tnzhy06/fallguard/docs/C09验收.md

# C09：MQTT、JSON 与远程命令

日期：2026-10-26。当前 C09 已实现并通过 Debug 编译和软件回放；电脑端已使用新部署账户验证云 Broker 的认证及临时主题 QoS 0 收发。**用户于 2026-10-26 确认 C09 验收通过。** 下文保留开发过程记录；除已记录日志外，不补写用户未提供的独立测量结果。 本轮不进入 C10，也不开发网站。

## 1. 本轮接入

- USART3 保持 115200、单字节中断接收和固定环形缓冲；发送使用中断，主循环推进 AT 状态机。
- Wi-Fi/SNTP 之后接 MQTT；SNTP 没有有效时间也可继续联网，未校时 ts=0。
- 使用 LinkID=0、TCP、QoS 0、Retain=false、Clean Session、Keep Alive=120。
- 连接且命令主题订阅成功后立即上报快照，之后默认 5 秒；周期可设 1～3600 秒。
- 在线报警、消警发送事件并尽快更新状态快照；离线不积存历史事件，恢复后只发当前状态。
- 保留取消自动 GMR、关闭 RTC 周期时间行的设置；GPS/OLED 本地卫星数显示不改，MQTT 不含 sat。

## 2. 配置与烧录

Wi-Fi 使用本机 `BSP/esp_config_local.h`。MQTT 使用本机 `BSP/mqtt_config_local.h`，已按用户提供的桌面资料填写当前 `114.55.210.224:1883` 与 `mqtt_device` 账户；密码不写入本文。两份本地配置均被 Git 忽略，CMake 只在文件缺失时从公开空模板创建，不覆盖现有配置。

仅提取了 MQTT 连接凭据，没有复制桌面目录中的管理员、网站账户或 SSH 私钥。更新部署密码后修改本地配置并重新编译。

编译 Debug 后烧录 [fallguard.elf](../build/Debug/fallguard.elf)。首次验收建议保持现有 RTC、GPS、MPU6050 和 JQ8900 接线不变；室内没有有效 GPS 也能测试 MQTT。

## 3. 启动指令

```text
AT
ATE0
AT+CWMODE=1
AT+CWJAP="本地配置的SSID","本地配置的密码"
AT+CIPSNTPCFG=1,8,"ntp.aliyun.com","ntp.sjtu.edu.cn","cn.ntp.org.cn"
AT+CIPSNTPTIME?
AT+MQTTCLEAN=0
AT+MQTTUSERCFG=0,1,"belt01","本地配置的MQTT用户名","本地配置的MQTT密码",0,0,""
AT+MQTTCONNCFG=0,120,0,"","",0,0
AT+MQTTCONN=0,"114.55.210.224",1883,0
AT+MQTTSUB=0,"fallguard/belt01/cmd",0
```

每条实际指令以 CR-LF 结束，上一事务完成后才能发送下一条。Wi-Fi 和 MQTT 账户配置的 TX/回显隐藏凭据。CLEAN 在无旧会话时返回 ERROR 可继续；其他 MQTT 事务失败进入恢复。

连接同时等待匹配 Broker 的 `+MQTTCONNECTED` 和最终 OK，允许两者任意先后。订阅最终确认前不允许业务上报。发送用普通 AT+MQTTPUB，原始 JSON 经 AT 转义，包含 CR-LF 的实际文本不超过 255 字节，NUL 另占 1 字节。

## 4. MQTTX 配置

| 设置 | 值 |
| --- | --- |
| 主机 | mqtt://114.55.210.224 |
| 端口 | 1883，关闭 TLS |
| MQTT 版本 | 3.1.1 |
| Client ID | fallguard-mqttx-pc；不要使用 belt01 |
| 用户名/密码 | 当前 MQTT 账户，不是 Dashboard 管理员账户 |
| 订阅 | fallguard/#，QoS 0 |
| 发布控制 | fallguard/belt01/cmd，QoS 0，Retain=false |

订阅全部主题时会看到自己发送的 cmd，这不是设备 ACK。设备只有 loc/alarm 上报，没有专用命令执行确认字段。发送控制前检查命令主题无历史保留命令。

位置示例：

```json
{"id":"belt01","ts":0,"lat":0,"lon":0,"fix":0,"st":"ok"}
```

报警示例：

```json
{"id":"belt01","ts":0,"ev":"fall","lat":0,"lon":0,"fix":0}
```

消警示例：

```json
{"id":"belt01","ts":0,"ev":"cancel"}
```

实际 ts 来自有效 RTC，否则为 0；实际经纬度为整数微度。失锁保留历史坐标但 fix=0，从未定位为零坐标且 fix=0。

## 5. 下行验收

逐条向 cmd 主题发送：

```json
{"cmd":"loc"}
{"cmd":"clear"}
{"cmd":"intv","v":1}
{"cmd":"intv","v":5}
```

loc 尽快请求最新快照；clear 仅在报警中解除，不会在正常状态触发报警；intv 从处理时重新计周期，范围 1～3600，MCU 重启恢复 5 秒。正常网络重连保留已设置的周期。

错误 JSON、缺参数、未知字段/命令、重复键、带尾随垃圾、字符串/小数/指数周期，以及 0、3601 均拒绝。完整下行载荷最多 127 字节，另留 NUL；固定命令 FIFO 为 4 项。按 URC 声明长度取载荷，载荷内部换行或 OK 不作为普通 AT 应答处理。

## 6. OLED 与日志

默认显示第 8 页 MQTT 页面；K1 循环原有 GPS/MPU/RTC 等页面，K2 保留本地测试/消警。MQTT 页显示连接阶段、Wi-Fi、上报周期、AT 发布成功/失败计数、命令丢弃/无效计数与 RX 丢字节。

PUB 表示 ESP 对发布事务返回成功，不能据此保证订阅者收到。LED 在 MQTT 订阅就绪后切正常模式，未在线仍为离线模式；报警优先快闪。

`DEBUG_LOG_MQTT` 控制连接/发布日志，`DEBUG_LOG_REPORT` 控制命令与业务 JSON；ESP/ESP_RX 与 RTC 启动/校时日志继续保留。`DEBUG_LOG_TIME_PERIODIC=0`，不会每秒输出重复 RTC 时间或未校准状态。

## 7. 恢复与限制

- MQTT 连接事务超时 30 秒，其他 MQTT 事务 10 秒；失败或接收失步后等待 30 秒，EN 拉低 100 ms 再启动。没有阻塞式等待。
- SNTP 有响应但时间无效，30 秒窗口结束后继续 MQTT，后续有限频率重试；SNTP 明确拒绝则本次 MCU 运行禁用后续 SNTP 并继续 MQTT，已有 RTC 保留。
- SNTP 事务无最终响应时先恢复 ESP，避免迟到 OK 污染后续事务；本次运行跳过后续 SNTP，从而允许重新联网后进入 MQTT。
- 在线事件 FIFO 为 4 项，满时记录丢弃；断线清空，重连只发当前快照。没有持久事件存储或离线补报。
- 本地最新报警状态先记录，再执行远程 clear，避免同一轮发生/解除报警时丢失事件；重复 clear 幂等，扶正再触发语义不变。
- 上报与校时共用一个 AT 事务通道，“立即”指下一次通道可用时调度，不保证严格端到端时延。QoS 0 也不保证每条事件送达。

## 8. 验收清单

| 操作 | 预期 |
| --- | --- |
| 启动并等待订阅 | 输出 `[MQTT] connected and command topic subscribed`，MQTTX 收到首条 loc |
| 连续观察至少 3 条 | 默认约 5 秒间隔，JSON 无 sat、无浮点经纬度 |
| 室内无定位 | fix=0 仍可收发；时间未校准时 ts=0 仍可收发 |
| 发送 loc | 尽快收到一次快照，不改变周期 |
| K2 报警 | 收到 fall、st=fall 快照，语音和 LED 正常 |
| 发送 clear，再重复 clear | 收到一次 cancel、st=ok；不额外触发报警 |
| 保持倾斜消警后再扶正/放倒 | 未扶正不重触发；扶正后再达到 60°/1 秒可触发 |
| 周期改 1，再改 5 | 实测间隔变化；非法周期拒绝 |
| 周期改 3600 后报警/消警 | 事件及状态不等待周期到期；验收后恢复 5 秒 |
| 断网期间报警、消警再重连 | 本地功能继续，重连仅上报当前状态，无历史补发 |
| 检查并发 | 记录 IMU dt/max、GPS 错误/丢字节，确认 JQ 播放不破坏接收 |

已验证：Debug 编译，RAM 8536 B、FLASH 74856 B；修改模块严格警告检查；[MQTT/JSON/上报回放](../tests/mqtt/README.md)、C08 正常/空配置回归、实际调度器回放及 OLED 帧缓冲检查。

云端电脑测试首次出现超时，复测完成当前账户认证、独立临时主题订阅与 QoS 0 往返，Retain=false；没有发送设备控制命令、修改 Broker 或保留测试消息。这个结果不代替 ESP-01S 实物验收。

待验证：重新烧录后的 ESP-01S MQTT 应答、MQTTX 上行/下行、真实断网恢复及本地任务并发。后续请提供 `[ESP]`、`[MQTT]`、`[REPORT]` 日志，不提供密码。

## 9. 实物连接通知端口带引号（2026-10-26）

用户日志确认 Wi-Fi 已获得 IP、SNTP 返回有效日期并写入 RTC，MQTT 用户配置和连接参数均收到 OK。ESP 发出的连接通知为：

```text
+MQTTCONNECTED:0,1,"114.55.210.224","1883","",0
OK
```

原代码仅匹配不带引号的数字端口，导致通知被忽略，虽有 OK 仍等待匹配通知，30 秒后在 state=15 超时。已修正为接受实物的引号端口及手册示例的数字端口；仍严格核对 LinkID=0、TCP scheme=1、主机、端口、空 path 与 reconnect=0，不仅凭 OK 就进入订阅。

Debug、ESP 严格警告检查与 MQTT 回放通过；新增覆盖两种端口形式、URC/OK 两种先后，以及错误主机/端口/LinkID/尾部拒绝。修复后尚待重新烧录确认订阅、上报和下行；不能将此前连接通知当成完整 C09 验收通过。首次 CLEAN 返回 ERROR 已由既有代码允许继续，无需因此改服务器配置。

## 10. 云端直接订阅确认实物周期上报（2026-10-26）

用户提供周期发布 OK 日志后，电脑使用独立 Client ID 连接当前云 Broker，只读订阅 `fallguard/#` 15 秒，收到 3 条 `fallguard/belt01/loc`：时间戳依次为 1793026466、1793026471、1793026476，均 Retain=false，间隔 5 秒。

实际载荷示例：

```json
{"id":"belt01","ts":1793026476,"lat":0,"lon":0,"fix":0,"st":"ok"}
```

该次确认设备周期位置消息已送达云端，并可由独立订阅者接收；不是只依据 AT OK 判断成功。fix=0 表示当前没有有效定位，零坐标不影响消息传输。电脑没有发布控制命令。

若 MQTTX 仍不显示，核对同一 Broker `114.55.210.224:1883`、当前 MQTT 账户、已连接状态及订阅 `fallguard/#` 或精确的 `fallguard/belt01/loc`；仅填前缀 `fallguard/` 或 `fallguard/belt01/` 不会匹配子主题。MQTTX Client ID 不得使用 belt01，界面消息筛选应清除。Retain=false 时新订阅等待下一条，不会立即获得过去的周期消息。

本轮仅确认周期 loc；设备下行执行、fall/cancel 事件、本地语音并发和断网恢复仍待用户验收，未据此进入 C10。

## 11. 用户阶段验收

2026-10-26，用户确认“验收通过”，要求将当前代码推送 GitHub，再重新设计 OLED 界面。C09 按用户确认验收通过；不据此编造未提供的并发采样测量、断网时延或其他独立测试数据。OLED 改版另行提交验收。
