tnzhy06/fallguard/docs/项目开发文档.md

# 弱势群体定位报警腰带 — 项目开发文档（修订稿 v0.2）

> **当前代码状态**：2026-10-25 按用户最新要求重新移植 leech001/MPU6050，OLED 与 USART1 实时显示三轴加速度、三轴角速度和 Roll/Pitch，保留 GPS、按键与 LED。现已启用用户确认的简单跌倒演示：任一角绝对值 ≥60° 持续 1 秒报警、K2 消警、扶正后重新待命；不使用原三段式。见 [实时数据显示验收](MPU6050实时显示.md)。

> 依据：`需求文档.md`、`约束.md`、`开源项目地址.md`、各模块 PDF 资料
> 状态：**开发前修订**；现有引脚按 AGENTS.md 与 fallguard.ioc 固定，待确认项见第 10.3 节。
> 已知硬件状态：ESP-01S 已刷入 **1471 号固件**；编号本身不等同于 AT/SDK 版本。
> 协议依据：JQ8900 一线协议以 `JQ8900语音模块16p.pdf` 为准；AT MQTT/SNTP 以 `ESP-AT User Guide.pdf` 为准。下文 PDF 页码均为阅读器物理页码（从 1 开始）。

---

## 1. 项目概述

做一条腰带式装置，佩戴者可被定位、可被判断状态。跌倒时本地中文语音报警，并通过网络把位置与跌倒事件上报服务器。

课程展示项目，目标是**功能跑通、代码简洁**，不做产品级可靠性设计（不做电源设计、不设计外壳）。

### 1.1 需求 → 实现映射

| 需求（需求文档） | 实现方式 |
|---|---|
| 解析 JSON，MQTT 通信 | ESP-01S 跑 AT MQTT 固件，STM32 发 AT 指令；上行 JSON 用固定缓冲区拼装并检查长度，下行用极简解析 |
| 解析 NMEA 获取位置 | ATGM336H 接 USART2，移植 `lwgps` 解析 |
| 简单跌倒演示 | MPU6050 Roll/Pitch 任一绝对值 ≥60° 持续 1 秒（见 5.2） |
| 上报经纬度 / 跌倒提示 | 周期上报 + 事件上报，两个 MQTT topic |
| 跌倒时中文语音报警 | JQ8900 一线串口，播放预存中文语音 |
| 实时发送位置和状态 | 5 s 周期上报（可被下行命令修改） |
| 区分正常躺下和跌倒 | 当前简化倾斜法不区分慢躺与跌倒，仅用于演示（见 5.2） |
| OLED 显示时间/网络/GPS 强度/位置 | 3 页界面 + 按键翻页（另加一页算法调试页），见第 6 章 |
| 其他创新性设计 | 见 10.2 |

---

## 2. 系统框图

```
                    ┌──────────────────────────────┐
   ATGM336H ──UART2─┤                              │
   MPU6050  ──I2C1──┤        STM32F103RCT6         │
   ESP-01S  ──UART3─┤        (CubeMX+HAL+CMake)     │
   JQ8900   ─1线GPIO┤                              │
   OLED     ─软I2C──┤  PB4/PB5                     │
   按键×2   ──GPIO──┤  PC8/PC9                     │
   LED      ──GPIO──┤  PA8                         │
                    └──────────┬───────────────────┘
                               │ USART1 PA9/PA10 → USB-TTL → 电脑串口助手
                               │
                    ESP-01S ──WiFi──► MQTT Broker ──► 后端订阅/展示
```

数据流：GPS/IMU 采集 → 状态判定（跌倒检测）→ 本地显示 + 本地语音 + MQTT 上报。

---

## 3. 引脚分配

### 3.1 约束已明确（不得改动）

| 功能 | 引脚 | User Label | 说明 |
|---|---|---|---|
| 调试串口 | PA9 / PA10 | — | USART1，TX/RX，接 USB-TTL |
| LED | PA8 | `LED` | 低电平点亮 |
| 按键 K1 / K2 | PC8 / PC9 | `KEY1` / `KEY2` | 低电平触发，需内部上拉 |
| OLED SCL / SDA | PB4 / PB5 | `OLED_SCL` / `OLED_SDA` | **软件 I2C**（原因见 3.3） |
| 不用 | PA0 | — | 保留 |

### 3.2 当前工程已采用的分配（不得擅自改动）

| 功能 | 当前引脚 | User Label | 外设 | 参数 | 备注 |
| --- | --- | --- | --- | --- | --- |
| GPS TX→MCU | PA3 | — | USART2_RX | 115200 8N1 | 用户已将模块设为 115200；模块原厂默认 9600 |
| GPS RX←MCU | PA2 | — | USART2_TX | | 仅发配置指令用；只接收时仅接 GPS TX→PA3，并共地 |
| ESP-01S RX←MCU  | PB10 | — | USART3_TX | 115200 8N1 | AT 固件默认 115200 |
| ESP-01S TX→MCU  | PB11 | — | USART3_RX | | |
| ESP-01S EN | PB12 | `ESP_EN` | GPIO 输出 | 默认高 | CH_PD 使能脚，见 3.4 |
| MPU6050 SCL/SDA | PB6 / PB7 | — | I2C1 | 400 kHz | |
| JQ8900 一线串口 | PB0 | `JQ_SDA` | GPIO | — | 接模块 VPP；保持 PB0，时序方案见 5.3 |
| JQ8900 BUSY | PB1 | `JQ_BUSY`  | GPIO 输入 | | 手册第 4 页：有音频输出为高，无输出为低 |
| RTC 时钟源 | PC14 / PC15 | — | LSE | 32.768 kHz | 板上晶振 |

**User Label 说明**：这是 CubeMX 里给引脚起的标签，生成后会在 `Core/Inc/main.h` 里变成 `#define LED_Pin GPIO_PIN_8` / `#define LED_GPIO_Port GPIOA` 这样的宏，代码里写 `HAL_GPIO_WritePin(LED_GPIO_Port, LED_Pin, ...)`，不写死 `GPIOA, GPIO_PIN_8`。
**外设引脚（USART/I2C/LSE）不用设标签**——CubeMX 已经用 `huart1`、`hi2c1` 这些句柄管理了。配置步骤见 `CubeMX配置指南.md` 第 4.0 节。

**冲突检查结果**：以上分配互不冲突。PB10/PB11 同时是 I2C2，本方案 I2C2 不用；PC10/PC11(UART4)、PC12/PD2(UART5) 空余，可作备用。

### 3.3 两个必须提前知道的坑

1. **PB4/PB5 不是 STM32F103 的硬件 I2C 引脚。** F103 的 I2C1 只在 PB6/PB7（或重映射 PB8/PB9），PB4/PB5 没有 I2C 复用功能。所以 OLED **只能用软件 I2C**——正好 `zeruns` 的驱动支持软件 I2C 模式，符合要求，但硬件 I2C 那条路走不通。
2. **PB4 上电默认是 JTAG 的 NJTRST。** 想把它当普通 GPIO 用，必须在初始化里关掉 JTAG、保留 SWD：
   `__HAL_RCC_AFIO_CLK_ENABLE(); __HAL_AFIO_REMAP_SWJ_NOJTAG();`
   只影响 PB3/PB4/PA15，SWD（PA13/PA14）不受影响，调试照常。

### 3.4 硬件连接注意

- 所有模块与 STM32 共地，区分模块电源电压与 IO 电平。JQ8900 手册第 3～4 页说明 IO 为 3.3 V；模块 DC-5V 引脚标注不超过 5.2 V。其第 12 页“串 1 kΩ”针对 **5 V 主机逻辑**，不能改写成“模块用 5 V 供电就要串电阻”。
- ESP-01S 使用稳定的 3.3 V 电源，不能接 5 V。供电能力按至少 500 mA 预留，确认现有开发板稳压器和连接线能承受 WiFi 瞬时负载；无需为本课程项目另做电源设计。供电建议可参见 [Espressif 硬件说明](https://www.espressif.com/en/products/socs/esp8266ex/resources/)。
- ESP-01S 的 CH_PD/EN 接 PB12，默认高。启动或连续 AT 超时时，可用状态机拉低 100 ms 后拉高并等待启动；这属于芯片使能复位，不是切断模块 VCC。等待期间本地任务继续运行。
- OLED 的 PB4/PB5 使用开漏输出，必须确认模块板已有上拉到 3.3 V 的电阻；没有则外接。STM32F1 输出模式下的 `GPIO_PULLUP` 不会开启内部上拉，不能靠该配置维持总线高电平。

---

## 4. 软件架构

### 4.1 分层

```
App 层     app_main(调度器+系统状态机) / app_fall / app_report / app_ui / app_json
BSP 层     bsp_oled / bsp_mpu6050 / bsp_gps / bsp_jq8900 / bsp_esp / bsp_key / bsp_led / bsp_delay / bsp_rtc
第三方     lwgps(NMEA) / 所选 OLED 驱动配套字库
HAL 层     CubeMX 生成 + STM32F1 HAL
```

### 4.2 不用 RTOS 的调度方式

主循环使用 `HAL_GetTick()` 时间片轮询，不用 RTOS。App 仅直接使用此 tick 接口，外设访问通过 BSP；RTC 日期时间读写由 `bsp_rtc` 封装。

```c
typedef struct { void (*fn)(void); uint32_t period; uint32_t last; } task_t;

static task_t tasks[] = {
    { gps_poll,    10, 0 },
    { imu_poll,    10, 0 },
    { net_poll,     5, 0 },
    { key_scan,    20, 0 },
    { ui_refresh, 100, 0 },
    { report_task,100, 0 },
};
```

`imu_poll` 每次取得有效新样本后，立即调用跌倒状态机；不能再用一个 20 ms 任务只看“最新值”，否则会跳过部分样本。上报任务按时间戳判断周期，默认 5 s；报警撤销窗口和其他期限也按 tick 判断，不靠任务执行次数计秒。

任务到期用无符号差值 `(uint32_t)(now - last) >= period` 判断，允许 tick 回绕。上述周期是调度目标，必须测量实际任务耗时和相邻 IMU 样本间隔；超时后不要连续读取同一时刻的数据伪装成补采样。

OLED 100 ms 只更新界面内容，实际传输在主循环中分小块推进。100 kHz I2C 下整屏 1024 字节仅数据和 ACK 就约 92 ms，不得一次阻塞刷新整屏；每批字节数按实测耗时限制。AT 等待、JQ8900 引导/字节间隔全部用状态机推进，禁止业务阻塞式长延时。C07 已采用 TIM3 中断推进 PB0 边沿；不改引脚、不用 DMA。

### 4.3 串口接收：单字节中断 + 环形缓冲

三个串口的数据率都不高，**都不用 DMA**：

| 串口 | TX | RX |
|---|---|---|
| USART1 调试 | 短日志 printf（GCC/newlib 重定向 `_write`） | 单字节中断，只用于收上位机的测试命令；用不上可以干脆不开 |
| USART2 GPS | 基本不用 | 单字节中断 → 环形缓冲 → 主循环喂 lwgps |
| USART3 ESP | 阻塞发送 AT 指令 | 单字节中断 → 环形缓冲 → AT 状态机解析 |

```c
void HAL_UART_RxCpltCallback(UART_HandleTypeDef *huart)
{
    if (huart == &huart2) { rb_push(&gps_rb, rx2); HAL_UART_Receive_IT(&huart2, &rx2, 1); }
    if (huart == &huart3) { rb_push(&esp_rb, rx3); HAL_UART_Receive_IT(&huart3, &rx3, 1); }
}
```

**实现边界**：115200 8N1 的满速字节率为 11520 B/s；接收中断只搬数据，CPU 占用需实测，不预先宣称固定低于 3%。USART1 RX 仅在需要测试命令时启用。

必须处理 UART 的 ORE 等接收错误并恢复单字节接收；环形缓冲由中断生产、主循环消费，写满时记录溢出并让对应解析器放弃不完整帧。GPS 重新寻找完整 NMEA 句并校验，ESP 按 URC 头和载荷长度解析。不得在丢失 MQTT 载荷后只靠“下一处 CRLF”判定已恢复同步；必要时使当前事务失败并重新建立会话。

JQ8900 不得整字节关闭全局中断。UART 中断需要在语音命令发送期间继续接收，AT 响应和 URC 仍可能到达。字节间隔也应让出主循环；不得假定丢失的命令必定由服务器重发。所有串口保持单字节中断与环形缓冲方案，不设 DMA 退路。

### 4.4 系统状态机

```
INIT ──► WIFI_CONNECT ──► SNTP_SYNC ──► MQTT_CONNECT ──► RUN
             ▲                                              │
             └──────────── 断线重连（net_poll 里检测）──────┘
```

`RUN` 表示 MQTT 已连接且命令 topic 订阅成功，才允许上报。网络未通时本地功能（GPS、跌倒检测、语音、OLED）继续运行，OLED 显示“离线”。SNTP 在限定重试后失败应继续进入 MQTT_CONNECT，保留“时间未校准”状态；具体重试期限在 C08 验证。离线事件是否补报见 10.3，不预设存在服务器重发或持久队列。

---

## 5. 关键模块设计

### 5.1 GPS 解析（移植 lwgps）

- 将 UART 环形缓冲中的字节在主循环喂给 `lwgps`，固定所用版本与配置，不引入动态内存分配。
- ATGM336H 原厂默认 9600 8N1；用户已将实际模块波特率设置为 115200，当前 USART2 同为 115200 8N1。模拟发送端也须使用 115200。按实际输出识别 GN/GP/BD 等 talker 前缀，不把 `GNGGA`、`GNRMC` 写死为唯一合法句子。GGA 提供坐标、定位质量、参与定位卫星数、HDOP 和海平面海拔，RMC 提供有效状态与 UTC 日期时间，GSV 提供可见卫星及信号值。C05 使用 lwgps 解析 GGA/RMC/GSA/GSV，HDOP 从其支持的 GSA 字段读取；本项目不展示速度。
- 原始 NMEA 坐标为 `ddmm.mmmm`，例如 `22 + 36.9453/60 = 22.615755`；**lwgps 的 latitude/longitude 已是十进制度**，不能再做一次度分转换。输出时按南/西为负换成有符号整数微度。海拔以整数厘米保存，显示时拆成米的整数和小数，不启用浮点 printf。
- BSP 保存上一次有效坐标及更新时间。无效定位时不把无效 NMEA 坐标覆盖进去；上报 `fix=0` 并沿用上次有效坐标。开机从未定位时坐标缓冲初始为 0，此时 `fix=0`，服务器不得把 (0,0) 当成真实位置。
- 用户已确认采用 **5 秒**过期规则：GGA 质量为 1/2/3、RMC=A 且两者均在 5000 ms 内更新时，`fix=1`；任一失效或达到 5000 ms 未有效更新则 `fix=0`。保留上次有效经纬度与海拔，OLED 标记 LAST 和位置年龄；首次定位前显示 WAIT 与占位符。`fix` 对外归一为 0/1，不直接照搬 GGA 的多值质量码。
- 信号来自校验通过的完整 GSV 组，以最大 C/N₀（dBHz）显示。用户已确认四档：无＝无有效数据、过期或值为 0；弱＝1～29；中＝30～39；强＝40～99。信号独立采用 5 秒过期规则，不用卫星数或 HDOP 代替，也不作为 fix 条件。GPS UTC 原样显示，不加 8 小时、不写 RTC。

### 5.2 简单跌倒演示（当前实现）

用户已确认简化方案：`|Roll| >= 60°` 或 `|Pitch| >= 60°` 持续 1000 ms，即锁定 OLED/LED 本地报警。期间恢复为两角均 <60° 则重新计时。K2 消警后须先恢复到两角均 <60°，才能再次自动触发；未报警时 K2 可手动测试。

此方案直接使用模块坐标角，适合平放/放倒的课程演示，缓慢放倒也会触发，不要求失重、冲击或静止判据；不使用之前的三段式或 10 s 本地等待窗口。不能据此宣称人体跌倒检出精度。

参数和状态在 App/app_fall.c/h，输入来自现有 BSP。只处理新有效样本，错误或完整保持时间无数据时重置候选；报警锁定须人工消警。原六面采集功能不恢复。接线、界面、测试及详细边界见 [简单跌倒演示验收](简单跌倒演示验收.md)。语音/联网仍按后续模块接入，不修改 MQTT topic/JSON。

### 5.3 JQ8900 一线串口语音（C07）

**唯一协议依据**：[JQ8900语音模块16p.pdf](JQ8900语音模块16p.pdf)，物理第 4、7～11 页。PB0 接模块 **VPP**，PB1 接 **BUSY**，共地；RX/TX 属于另一套两线 UART 协议。

手册第 7 页规定按字节 **LSB 先发**，0 的高:低为 1:3，1 为 3:1。第 10 页代码的 210/500 µs 与第 7 页图中 >400/>1200 µs 标注不一致，不能混为同一套时序。C07 采用满足图示下限与比例的较长脉宽，模块识别结果仍须实测：

| 项目 | 手册依据 | C07 设置 |
|---|---|---|
| 空闲与开始 | 第 10 页开始置高 1000 µs，结束回高 | 空闲高，字节前高 1 ms |
| 引导低电平 | 第 7 页 >2 ms，第 11 页建议 4 ms | 低 4 ms |
| 数据 0 | 第 7 页短高/长低，1:3 | 高 500 µs、低 1500 µs |
| 数据 1 | 第 7 页长高/短低，3:1 | 高 1500 µs、低 500 µs |
| 字节间隔 | 第 11 页建议大于 10 ms | 完成字节后主循环等待至少 12 ms，再开始下一字节 |

单字节标称 `1 + 4 + 8 × 2 = 21 ms`；三字节选曲至末位结束约 `3 × 21 + 2 × 12 = 87 ms`，实际还包括调度和中断延迟。TIM3 使用 1 MHz 内部计数，预分频 71、关闭 ARR 预装载，中断推进 PB0 边沿；配置已通过 CubeMX 生成，不占用外部定时器引脚。TIM2 保留原用途。引导和字节间隔均不阻塞业务，不整字节关闭全局中断，不使用 DMA。需上板核对脉宽及 GPS/IMU 并发。

**选曲指令**（第 8～9 页）：先 `0x0A` 清空数字，再按十进制高位到低位发送原始数字 `0x00～0x09`，最后 `0x0B` 确认。例如第 2 首 `0A 02 0B`，第 15 首 `0A 01 05 0B`。数字不是 ASCII；每个字节内部仍按 LSB 先发。

| 本轮用途 | 字节（十六进制） |
|---|---|
| 选择 FLASH | `1A` |
| 停止 | `13` |
| 音量 20（手册示例） | `0A 02 00 0C` |
| 选择第 1 首 | `0A 01 0B` |

用户已确认 FLASH 根目录有五位数字文件名 **00001.mp3**，自动报警和 K2 测试报警共用此曲目。K2 消警发送停止指令，不播放取消提示；开机只设置 FLASH、停止和音量，不播放开机曲。上电等待 1 秒是本项目调度参数，并非手册保证的启动时间。

BUSY 按第 4 页定义为有音频输出高、无输出低。用户已确认接 PB1；报警持续时，观察到 BUSY 高转低才重新选曲。未观察到高电平则停在等待状态，不盲目重复发送。未使用 `0x0E`，不把两线 UART 章节的循环模式数字套入一线协议。消警保留当前字节完整，丢弃未发送的选曲字节，满足间隔后优先发送 `0x13`。

实现与硬件验收步骤见 [C07验收.md](C07验收.md)。软件发送完成不代表模块已识别或实际有声音。

### 5.4 ESP-01S 网络（1471 号固件，AT 指令状态机）

**已确认事实**：ESP-01S 已刷入 **1471 号固件**。本项目以 [ESP-AT User Guide.pdf](ESP-AT%20User%20Guide.pdf) 为指令依据，不由“1471”推导 AT/SDK 版本、Flash 分区或缺省 UART 引脚，也不要求重新刷固件。

C08 已收到用户提供的 `AT` / `AT+GMR` 日志，实测版本与 SNTP 未同步现象见 [C08校时与RTC验收.md](C08校时与RTC验收.md)；后续继续验证 WiFi、SNTP 和本节 MQTT 指令。若实物响应与 PDF 不同，记录差异再核对该固件，不能擅自删除 `LinkID`、更换固件或改引脚；这是能力验证，不是重新讨论固件选型。

用非阻塞状态机串行发送命令，每条实际发送文本以 CR-LF 结束；上一条未结束前不下发下一条。以下为手册语法的项目参数示例，`ssid/pwd/broker` 是待填写参数：

| 步骤 | 指令 | 完成条件/注意 |
|---|---|---|
| 探测 | `AT` | `OK`；已取消自动 `AT+GMR`，已有版本记录保留，必要时手动查询 |
| 关闭回显 | `ATE0` | `OK` |
| STA 模式 | `AT+CWMODE=1` | `OK` |
| 连 WiFi | `AT+CWJAP="ssid","pwd"` | 等最终 `OK/ERROR`；另行处理 `WIFI CONNECTED/WIFI GOT IP` |
| 查 IP | `AT+CIPSTA?` | `+CIPSTA:ip:"..."` 等字段及最终 `OK` |
| SNTP 配置 | `AT+CIPSNTPCFG=1,8,"ntp.aliyun.com","ntp.sjtu.edu.cn","cn.ntp.org.cn"` | `OK` 仅表示配置完成，不表示已获得有效时间 |
| 读时间 | `AT+CIPSNTPTIME?` | `+CIPSNTPTIME:<asctime style time>` 与 `OK`；检查时间有效性 |
| MQTT 用户配置 | `AT+MQTTUSERCFG=0,1,"belt01","","",0,0,""` | `OK`；需要鉴权时填写用户名密码 |
| MQTT 连接参数 | `AT+MQTTCONNCFG=0,120,0,"","",0,0` | `OK` |
| MQTT 连接 | `AT+MQTTCONN=0,"broker",1883,0` | 处理连接 URC 与最终结果；末参数 0 表示由 STM32 状态机管理重连 |
| 订阅 | `AT+MQTTSUB=0,"fallguard/belt01/cmd",0` | `OK` 或手册定义的已订阅响应 |
| 发布字符串 | `AT+MQTTPUB=0,"fallguard/belt01/loc","<转义后的JSON>",0,0` | `OK`；占位文本不能照发 |
| 断开并清理 | `AT+MQTTCLEAN=0` | `OK`；仅在需要清理会话时使用 |

MQTT 参数对应手册第 204～213 页（印刷页 200～209）：`LinkID` 当前仅为 0，`scheme=1` 是 TCP；`CONNCFG` 第三个参数 0 表示启用 clean session。本项目按 `USERCFG → CONNCFG → CONN → SUB` 配置；不要将项目选择的 CONNCFG 步骤误写成协议永远不能省略的必选步骤。重连成功后重新确认连接和订阅状态。

启动/恢复可通过 EN 拉低 100 ms 再拉高，并等待固件就绪；连续超时 3 次时可进入这条恢复路径。等待必须让出本地任务。SNTP 失败不得永久阻塞 MQTT；超时值在 C08 根据 1471 固件响应实测确定。

**接收帧**（第 212、216 页）：

```text
+MQTTSUBRECV:0,"fallguard/belt01/cmd",13,{"cmd":"loc"}
+MQTTCONNECTED:0,1,"broker",1883,"",0
+MQTTDISCONNECTED:0
```

`{"cmd":"loc"}` 是 13 个 ASCII 字节。SUBRECV 的数据按声明长度截取，不把 JSON 内部或后续 CR-LF 当作载荷结束；UART 一次接收与一条 URC 也没有一一对应关系。完整载荷复制到有界缓冲区并补 NUL，再交 App 解析。普通 AT 应答和 URC 可以交错到达，应分别识别。

**上行转义与长度**：

- `app_json` 只生成原始 JSON，AT 参数转义由 `bsp_esp` 处理。按手册第 244 页（印刷页 240），字符串内容中的反斜杠、逗号和双引号分别编码为 `\\`、`\,`、`\"`；参数分隔逗号及参数外层引号不转义。
- 以下只演示转义，不是完整业务报文。原始 JSON 为 `{"id":"belt01","fix":0}`，串口实际文本为：

```text
AT+MQTTPUB=0,"topic","{\"id\":\"belt01\"\,\"fix\":0}",0,0
```

对应 C 字符串需再经过 C 语言自身的一层转义：

```c
"AT+MQTTPUB=0,\"topic\",\"{\\\"id\\\":\\\"belt01\\\"\\,\\\"fix\\\":0}\",0,0\r\n"
```

- 手册第 244 页的 `sensor:012` 特殊字符示例不宜直接当成合法 JSON 模板；项目按字段生成合法 JSON，并在订阅端验证收到的原始字节。
- `AT+MQTTPUB` 的 **整条 AT 命令**受 256 B 限制，topic 最长 128 B；检查转义膨胀后的命令长度，发送缓冲区还需容纳 CR-LF 和 NUL，不把它解释为“单独可发 256 B JSON”。
- 手册第 210～211 页的 `AT+MQTTPUBRAW=0,"topic",<length>,0,0` 是另一种发送方式：等 `OK` 和 `>` 后发送恰好 length 个原始载荷字节，不做 AT 转义、不附加 CR-LF；再等 `+MQTTPUB:OK/FAIL`。ESP8266 的默认 512 B MQTT 缓冲包含 MQTT 头和 topic 开销，不能视为 512 B 可用 JSON。是否采用 RAW 在 C09 实现时确定。

### 5.5 时间同步

C08 第一部分已实现 Wi-Fi/SNTP 与 RTC，具体配置、状态和验收见 [C08校时与RTC验收.md](C08校时与RTC验收.md)。C07 已于 2026-10-26 经用户确认验收通过；MQTT 接入留待后续。

联网后配置 SNTP，再轮询到有效时间，通过 BSP 写入 STM32 RTC；此后 RTC 由 LSE 独立走时。SNTP 配置成功不等于同步成功；返回未同步时间、无效日期或超时不能置“已校准”。后续接入 MQTT 时 SNTP 超时不得阻塞其建立；本轮仅校时，首次未成功仍标注“时间未校准”，已有有效 RTC 则保留，联网后安排有限频率的校时重试。

`AT+CIPSNTPTIME?` 见手册第 114～116 页（印刷页 110～112），返回 `Www Mmm dd hh:mm:ss yyyy`，例如 `Sat Oct 24 21:30:00 2026`。解析英文月份和日期，兼容个位日期的空格填充。按 `CIPSNTPCFG=1,8,...` 得到的本地时间写入 RTC，不能再加一次 8 小时。

上报 `ts` 定义为 **Unix UTC 秒**：RTC 保存东八区日历时，将本地日历转换为 UTC（减去 8 小时，处理跨日）再计算距 1970-01-01 00:00:00 UTC 的秒数。不能直接把 F1 的 RTC 计数寄存器当成 Unix 时间。当前 BSP 以 BKP 保存的校时日午夜 UTC 基准加 RTC 累计秒维护日历，避免 HAL 的 RAM 日期在复位后丢失；后续 RTC 访问统一通过 BSP，不能混用 HAL 的日内计数回绕读取。未完成有效校时则 `ts=0`，服务器不得把它解释为真实事件时间。持续时间判断全部使用 tick，不受校时跳变影响。

### 5.6 JSON 处理

**上行**：在固定大小缓冲区内用 `snprintf` 拼装并检查返回长度，避免引入 cJSON 的 malloc。
经纬度用**整数微度**（`lat × 10⁶`）传输，即 `"lat":22615755`，这样完全不用浮点 `printf`，省掉 `-u _printf_float` 带来的几 KB 开销，不代表 GPS 测量或度数转微度过程没有误差。

**下行**：只支持下面的固定命令集合，不引第三方库。在 AT 层确认完整载荷后，用 `strstr` 定位键并校验冒号、字符串边界及数值结束位置；拒绝截断载荷、缺失参数、无效数字和超出 C09 确认范围的周期。不能把“找到了子串”当作任意 JSON 的完整解析。解析后交给系统状态机执行。

```text
/* 上行：周期位置状态  topic: fallguard/belt01/loc */
{"id":"belt01","ts":1761288000,"lat":22615755,"lon":114141317,"fix":1,"st":"ok"}

/* 上行：跌倒报警    topic: fallguard/belt01/alarm */
{"id":"belt01","ts":1761288000,"ev":"fall","lat":22615755,"lon":114141317,"fix":1}

/* 上行：取消报警    topic: fallguard/belt01/alarm */
{"id":"belt01","ts":1761288000,"ev":"cancel"}

/* 下行：服务器命令  topic: fallguard/belt01/cmd */
{"cmd":"loc"}          /* 立即上报一次位置 */
{"cmd":"clear"}        /* 清除报警状态 */
{"cmd":"intv","v":30}  /* 修改上报周期为 30 s */
```

以上代码块的注释只用于解释 topic，每次实际载荷只有一个 JSON 对象，不带注释。字段名、topic 和命令名保持不变。

MQTT 未上报卫星数，载荷不含 `sat`；GPS/OLED 本地卫星数展示保持不变。

字段说明：`ts` 为 Unix UTC 秒、未校时为 0；`fix` 为归一化的有效定位标志 0/1，含过期判断；`st` 为 `ok` / `fall`。从未定位时坐标为 0 且 fix=0，有历史有效位置时失锁沿用该坐标。

### 5.7 按键与 LED

| 器件 | 功能 |
| --- | --- |
| K1 (PC8)  | 短按切换 OLED 页面（正常 3 页 + 调试页循环） |
| K2 (PC9)  | 短按：报警中 → 取消报警；非报警中 → 手动触发一次测试报警 |
| LED (PA8) | 慢闪(1 Hz) = 系统正常；快闪(5 Hz) = 报警中；常亮 = 网络未连接；常灭 = 未初始化完成 |

---

## 6. OLED 界面设计（当前实现）

K1 在六页间循环：MPU6050（默认）、GPS 信息、GPS 信号、字符、中文、图形。MPU 页继续同时显示六轴和 Roll/Pitch，底部显示 FALL:READY、HOLD:xxx/1000ms 或 RAISE TO REARM。

自动触发时任意页面反色覆盖 FALL DEMO；K2 手动测试显示 TEST ALARM；均按 K2 取消。报警期间 K1 可以翻动底层页，消警后回到该页。GPS 信号仍用 0～3 个信号格，不显示中文等级文字。

显示和采样解耦：目标 100 Hz 采样，每个新样本参与判定，OLED 约 100 ms 更新并小块传输。单位与实时输出见 [MPU6050 显示验收](MPU6050实时显示.md)，演示操作见 [简单跌倒验收](简单跌倒演示验收.md)。

---

## 7. 开源项目移植方案

| 项目 | 许可 | 移植内容与改动 |
|---|---|---|
| `zeruns/STM32G4-OLED-SSD1306-I2C-HAL` | LGPL-3.0 | 取 `OLED.c/h` + 字库。**改动**：G4 HAL → F1 HAL；打开软件 I2C 模式（PB4/PB5 无硬件 I2C）；GPIO 初始化改用 F1 的 `GPIO_InitTypeDef`；延时函数换成自己的 µs 延时。原作者代码本身源自江协科技的 F103 软件 I2C 版，回移改动量不大。 |
| `MaJerle/lwgps` | MIT | 固定版本，拷入该版本所需源文件、配套头文件和选项文件；常见上游布局为 `lwgps/src/` 与 `lwgps/src/include/`，include 路径必须与复制后的目录对应。坐标输出已为十进制度；核对所需句子和数值类型配置，不只复制单独一对 c/h。 |
| `leech001/MPU6050` | GPL-3.0 | 取 `Src/mpu6050.c/.h`。**改动**：函数接收 I2C 句柄，BSP 传入 `&hi2c1`；原库同时给出 `KalmanAngleX/Y`。默认加速度 ±2 g、陀螺仪 ±250 °/s，采样寄存器配置不等于主循环 100 Hz；需在 C04 核对输出率、滤波及量程并同步换算系数。原库的 Z 轴 `14418.0` 是固定校正值，不可照搬为本机标定；冲击可能使 ±2 g 单轴饱和，量程选择先实测确认。姿态定义按 5.2 实现。 |

> 移植时保留原作者声明、LICENSE 和所选版本记录；课程展示不能作为删除许可说明的理由。发布或分发时按相应许可证核对要求，本节不作豁免判断。

---

## 8. 开发环境与工程结构

**工具链**：STM32CubeMX 生成初始化代码 → CMake + arm-none-eabi-gcc 编译 → VSCode + Cortex-Debug 插件 + ST-Link/OpenOCD 下载调试。AI agent 辅助写业务代码。

```
fallguard/
├─ CMakeLists.txt
├─ STM32F103xx_FLASH.ld
├─ cmake/gcc-arm-none-eabi.cmake
├─ Core/            CubeMX 生成（main.c / stm32f1xx_it.c / msp）
├─ Drivers/         CMSIS + STM32F1xx_HAL_Driver
├─ BSP/             bsp_oled / bsp_mpu6050 / bsp_gps / bsp_jq8900
│                   bsp_esp / bsp_key / bsp_led / bsp_delay / bsp_rtc
├─ App/             app_main / app_fall / app_report / app_ui / app_json
├─ ThirdParty/      lwgps/  所选 OLED 驱动配套字库
└─ Tools/server.py  Python MQTT 订阅端，演示时在电脑上跑，打印收到的 JSON
```

**CubeMX 配置要点**：时钟 HSE 8 MHz → PLL → 72 MHz；USART1 115200（调试）、USART2 115200（GPS，实际模块已由用户设为 115200）、USART3 115200（ESP），GPS/ESP 开接收中断，调试 RX 按需启用（均不配 DMA，见 4.3）；I2C1 400 kHz；RTC 时钟源选 LSE；使能 TIM 用于 µs 延时（TIM2 计数器；C07 已使用 TIM3 推进 JQ 边沿）。

### 8.1 后端 / 演示端范围

网站与后端按课程演示规模开发，独立于固件 C01～C10。用户已增加网站需求，详细设计见[网站开发文档](网站开发文档.md)，实施提示词见[网站 Agent 提示词](网站Agent提示词.md)：

- MQTT Broker 使用用户已重新部署的云端 EMQX `114.55.210.224:1883`，业务协议见[MQTT 课程演示方案](MQTT课程演示方案.md)。
- MQTTX 保留为收发测试工具，订阅 `fallguard/#` 或单设备主题，用于与网站和实物交叉验证。
- 网站采用普通 HTML/CSS/JavaScript + FastAPI + paho-mqtt，单页展示位置、报警和最近 20 条内存消息，保留三个下行命令；不做登录、数据库或管理功能。源码放在独立 `web/`，浏览器不持有 MQTT 凭据，不直接连接 TCP 1883。
- 早期 `Tools/server.py` 控制台方案不再作为必须产出；网站按简易版 W01～W03 单独推进，不占用固件 C01～C10 阶段。

---

## 9. 开发计划

| 编号 | 任务 | 产出 |
|---|---|---|
| C01 | 工程骨架 | CubeMX+CMake+VSCode 跑通，LED 闪烁，串口 printf 可用 |
| C02 | 按键 + LED | 消抖、状态指示 |
| C03 | OLED 显示 | 移植 zeruns，软件 I2C，能显示字符/中文/图形 |
| C04 | MPU6050 | 核对量程、采样率、校准、安装轴，读取数据 + Kalman 双轴角度，串口验证 |
| C05 | GPS | USART2 115200 单字节中断 + lwgps；显示 UTC、经纬度、海拔、卫星数、HDOP 与四档信号，不展示速度 |
| C06 | 简单跌倒演示 | 用户已确认 60°/1秒，K2 消警、扶正后重新待命；本轮等上板验收，语音在 C07 接入 |
| C07 | JQ8900 | 按 PDF 核对图/示例差异并实测波形；指定选曲、循环/停止及 BUSY；确认不丢 UART 数据、不中断 IMU 调度 |
| C08 | 网络 + 校时 | 在**已刷入的 1471 号固件**上保留已取得的版本记录并验证 PDF 指令；AT 状态机、WiFi、SNTP、RTC，以及校时失败后继续 MQTT 的路径 |
| C09 | MQTT + JSON | 上行拼装、下行解析、重连已实现并编译/回放通过；实物待 [C09验收](C09验收.md) |
| C10 | 联调 | OLED 四页界面（交付时关掉调试页）、整机演示、Python 订阅端 |

顺序原则：**先把不依赖网络的本地功能全部做完**（C01~C07），最后再做网络（C08~C09），这样网络卡住也不影响演示。

---

## 10. 风险与待确认事项

### 10.1 风险与验证

| # | 风险 | 影响 | 应对 |
|---|---|---|---|
| 1 | 已刷入的 1471 号固件尚无本项目实测版本响应/能力记录 | 指令与实物不匹配 | C08 经现有串口记录 AT+GMR，验证 PDF 的 WiFi/SNTP/MQTT 指令；不推断 NonOS 语法、不自行重刷 |
| 2 | 简单倾斜法不能区分慢躺与跌倒 | 只适合演示 | 已按用户确认简化，不宣传真实跌倒检测准确率 |
| 3 | JQ8900 图与代码的绝对脉宽不一致 | 无法选曲或时序影响其他任务 | C07 示波器测量并验证识别；保留中断接收，不整字节关全局中断、不改 IO 控制 |
| 4 | OLED 整屏传输、日志及驱动阻塞 | IMU 漏采样、URC 缓冲溢出 | 分批刷屏、限制日志与驱动等待，记录实际采样间隔 |
| 5 | PB4 的 JTAG 功能未释放或 OLED 没有外部上拉 | OLED 不显示 | 保留 SWD、关闭 JTAG；确认上拉至 3.3 V |
| 6 | LSE 起振未验证 | RTC 不走时 | C01 检查 RCC 返回值和 RTC 走秒，未校时不生成伪时间戳 |
| 7 | ESP 实物 MQTT 收发与断线恢复尚未验收 | 设备与云端链路待验证 | 连接规则已确认、电脑 Broker 复测通过，按 [C09验收](C09验收.md) 完成实物步骤 |
| 8 | 室内或遮挡条件下 GPS 无定位/定位过期 | 演示无有效位置 | 尽量在开阔环境提前上电；显示未定位，按 fix 标记无效坐标；首次定位时间随环境变化 |
| 9 | 经验阈值、量程与安装方向未标定 | 跌倒误报/漏报、冲击轴饱和 | C04/C06 用正常活动与受控装置运动数据标定，记录原始数据和量程；不要求佩戴者做危险摔倒 |

### 10.2 创新性设计小结

1. 简单角度保持判定，便于课堂通过放平/放倒演示报警与消警
2. K2 消警并要求扶正后才重新待命，方便重复演示
3. 下行 MQTT 命令，支持远程查询位置、消警、改上报周期
4. 经纬度用整数微度传输，避免浮点 printf，节省 Flash
5. 失锁时沿用上次有效坐标并置 `fix=0`；从未定位时的零坐标也必须由 fix 标记无效
6. OLED 三页界面 + 报警自动跳页 + 状态栏图标，另加一页算法调试页实时显示跌倒判据数据

### 10.3 待确认与验收事项

1. 引脚按第 3 章与 AGENTS.md 固定，不重新分配；实际接线与表不一致时先反馈。
2. 当前已确认任一角绝对值 ≥60° 持续 1 秒、K2 消警后扶正重启；变更这些规则须先确认，旧三段式参数不再使用。
3. MQTT broker 为 114.55.210.224:1883，当前 mqtt_device 凭据仅存本地；允许 1～3600 秒、默认 5 秒；断网不补报历史 fall/cancel，重连只发当前快照，已确认。
4. K1 翻页、K2 消警/测试的键位交互在 C02 验证。
5. C07 根据 JQ 手册测定脉宽和模块识别情况，验收 UART 接收与 IMU 调度并发；BUSY 按手册高有效并核对实物。
6. C08 保存 1471 号固件的 AT+GMR、SNTP 与 MQTT 实测应答，核对 PDF 差异；用户已提供刷入状态，不再将重新刷机设为前置条件。
