tnzhy06/fallguard/docs/C04验收.md

# C04 MPU6050 移植与验收

> 历史 C04 验收记录。当前已按用户最新要求重新接入六轴与 Roll/Pitch 实时显示，操作以 [实时数据显示验收](MPU6050实时显示.md) 为准。

C03 已由用户确认通过，其代码已先推送到 GitHub，提交为 9d9252653e2d782cc1ccb9ae2273a3bc4af170e9。本阶段仅接入 MPU6050 与串口验收，等待用户上板通过后再进入 C05。

## 来源与修改

按 docs/开源项目地址.md 第三项移植 [leech001/MPU6050](https://github.com/leech001/MPU6050)，固定版本、许可证、原函数对应关系及修改详见 [移植记录](https://github.com/tnzhy06/fallguard/blob/192dd30bb0c6b0089e8cfefb9ca4f908d651d6c9/ThirdParty/leech001_mpu6050/README.md)。

- ThirdParty/leech001_mpu6050/mpu6050.c/h：原库的整组数据读取、换算和双轴 Kalman 算法；修复 Z 轴固定校正值、平方溢出、首帧时间跨度、90°边界及头文件卫哨。
- BSP/bsp_mpu6050.c/h：I2C1 接入、时间片初始化、200 个有效样本的陀螺仪零偏校准、整数样本接口。
- App/app_main.c：轮询传感器、状态变化和分时诊断日志；保留 K1 翻页、K2 测试报警及 LED 功能。
- App/app_ui.c：阶段标识改为 C04，保留已验收的三页界面。
- Core/Src/main.c：仅 USER CODE 块，更新启动提示，撤下持续的 RTC/TIM2 日志，为 100 Hz 采样减少同步串口开销；RTC 配置未改。
- 根 CMakeLists.txt：加入驱动和头文件目录。

## 接线

| MPU6050 模块 | STM32 |
|---|---|
| VCC | 3.3 V，按实际模块供电要求确认 |
| GND | 共地 |
| SCL | PB6 / I2C1_SCL |
| SDA | PB7 / I2C1_SDA |
| AD0 | GND，7 位地址固定 0x68 |
| INT、XDA、XCL | 本阶段不接 |

确认 SCL/SDA 有上拉至 3.3 V（先检查模块自带电阻），不能上拉至 5 V。沿用已有 CubeMX I2C1 400 kHz 配置，不改引脚。AD0 高时地址为 0x69，本阶段不自动扫描或更改地址；WHO_AM_I 期望仍为 0x68。

## 配置与校准范围

传感器加速度 ±2 g（16384 LSB/g）、陀螺仪 ±250°/s（131 LSB/(°/s)）。配置 DLPF=3，陀螺仪基准输出 1 kHz，SMPLRT_DIV=9，目标输出 100 Hz。配置并读回核对后，每隔至少 2 ms 检查 DATA_RDY；只有新数据才读取 14 字节并参与处理。没有 FIFO，不补造主循环错过的样本。

启动通过 tick 分阶段等待上电、复位和陀螺仪稳定。启动后请放稳模块约 3 秒，直到输出 gyro bias；其中 200 个有效新样本用作三轴陀螺仪均值零偏，之后从角速度中减去该偏置。校准不自动识别运动，若期间移动过，放稳后按复位重新校准。偏置只保存在 RAM，不写 Flash。

这不是完整 IMU 标定：加速度使用原厂名义系数，不扣除重力、不照搬上游 Z 轴系数；六面比例/零偏校准和腰带安装零位需本次实测记录。±2 g 仅用于初期驱动验收，不能据此宣称冲击测量合格；如运动中接近 ±2000 mg，记录后确认更大量程及其换算系数，再修改。跌倒阈值和阶段③语义仍留 C06 确认。

## 编译和烧录

VS Code 选择 Debug，执行 CMake: Configure，然后 CMake: Build，构建整个工程。烧录 build/Debug/fallguard.elf，复位后通过 USART1（PA9/PA10，115200 8N1）查看日志。不要对头文件或文档执行“编译当前文件”。

正常启动应见：

    === fallguard C04 ===
    [C04] HCLK=72000000 Hz LSE_READY=1
    [C04] MPU6050 @0x68: keep STILL for boot gyro calibration (~3s)
    [C04] WHO=0x68 cfg OK: 2g/250dps 100Hz DLPF=3; keep STILL
    [C04] gyro bias mdps=...,...,...

后续每 250 ms 输出一类诊断，一秒轮换完四类；四行不是同一时间的快照，示例数字只说明单位：

    [C04] A mg=0,0,1000
    [C04] G mdps=0,0,0
    [C04] K cdeg=0,0 T cdeg=3653
    [C04] N=100 dt=10 max=12 tick=3450

| 字段 | 含义 |
|---|---|
| A mg | X/Y/Z 加速度，1000 = 1 g；保留重力 |
| G mdps | 扣除启动零偏后的 X/Y/Z 角速度，1000 = 1°/s |
| K cdeg | Kalman X/Y 角度，100 = 1°，不是已标定的身体倾角 |
| T cdeg | 芯片内部温度，3653 = 36.53°C，不代表人体温度 |
| gyro bias mdps | 本次启动测得的三轴零偏 |
| N | 校准结束后处理的有效样本总数，校准 200 点不计入 |
| dt、max | 最近及本次启动最大样本间隔，单位 ms；首样本 dt=0 |
| tick | 最新样本的 HAL tick，单位 ms |

日志不使用浮点 printf。每秒对比 N 差和 tick 差，实际处理频率为 ΔN×1000/Δtick；正常应接近 100 Hz，dt 会因毫秒刻度、软件 I2C 刷屏、同步串口打印而有抖动。持续明显不足或 max 明显增大时，保留日志排查；寄存器配置为 100 Hz 不等于已验证实际处理率。

## 上板检查

1. 静止启动：确认 WHO/config 成功、约 3 秒后有偏置及持续变化的 N。静放时 G 应在零附近波动，A 合模应接近 1000 mg。记录偏置、抖动和实际频率，不把示例中的精确零当成要求。
2. 六面静放：依次让传感器的 ±X、±Y、±Z 轴朝上，对应轴分别应接近 ±1000 mg，其余轴近零。记录六组数据，核对轴箭头和符号，尤其确认 Z 没有使用上游私有校正系数。
3. 慢速绕 X、Y 转动：观察对应 G 的符号和 K 的变化，再静置观察是否稳定。以 Z 朝上的初始姿态测试约 45°及 90°。本算法 X 角范围约 ±90°、Y 角范围约 ±180°，pitch 跨 ±180°时允许数值跳号；没有融合磁力计，不输出航向角。任意姿态下单轴角不能直接解释成身体倾角。
4. 固定到腰带并记录安装：写下传感器 +X/+Y/+Z 分别朝向人体哪里，记录直立、前倾、侧倾和横放时的三轴 A 与 K，供 C06 选择直立参考重力方向；本阶段不自动设置身体倾角零位。
5. 同时翻页、按 K2：OLED、LED 和按键应继续响应；K2 仍只是测试报警开关。观察 N 与 max，确认刷屏和按键日志对采样的实际影响。本阶段没有跌倒报警判定。
6. 量程观察只需手持模块平稳转动、轻晃，不需要真人跌倒。记录是否出现 A 接近 ±2000 mg 或 G 接近 ±250000 mdps 的削顶；陀螺仪校正后读数略超名义边界不能单独证明未饱和。

若显示 MPU stopped，先看紧邻其前的详细诊断：

| 日志 | 定位 |
|---|---|
| MPU W reg=0x6B + failed at device reset | 首次复位寄存器写入失败，尚未读取 WHO_AM_I |
| MPU R reg=0x75 | 读取器件 ID 的 I2C 事务失败 |
| MPU WHO_AM_I=... expected=0x68 | I2C 读取成功，但 ID 不符合当前驱动；不要直接放宽检查 |
| MPU W reg=... | 对应配置寄存器写入失败 |
| MPU verify reg=... got=... expected=... | I2C 读取成功，但配置读回不符 |
| MPU R reg=0x3A / 0x3B | 采样时读取数据就绪标志 / 数据失败 |

通信错误会带 HAL、err 和 BUSY。HAL=1/2/3 分别为 HAL_ERROR/HAL_BUSY/HAL_TIMEOUT；err 是本工程 HAL 的位掩码：0x00000004 为应答失败 AF（可能在地址或数据阶段），0x00000020 为超时，0x00000001 为总线错误，0x00000002 为仲裁丢失。BUSY 是失败时的外设状态位，BUSY=1 不能单独证明哪根线被拉低。HAL 状态与 err 应一起判断。

检查供电、共地、上拉、SCL→PB6、SDA→PB7 和 AD0→GND。需要时测模块供电，以及总线空闲时 PB6/PB7 是否都接近 3.3 V。OLED 使用 PB4/PB5 软件 I2C，其正常不代表 MPU 所在的硬件 I2C1 正常。初始化/读取失败后停止本模块采样，不循环阻塞重试；断电检查接线后重新上电，并提供完整新日志。OLED/按键/LED 仍由主循环维护。若 N 不再增长，即使没有总线错误也不能视为采样正常，应一并提供状态日志。

## 已验证与待验证

- Debug 交叉编译链接通过；实际移植源与 BSP 的本机模拟 HAL 数值测试通过。
- 模拟故障并核对详细诊断中的失败寄存器、ID 实际值、配置实际值、HAL 错误码及 BUSY 快照。
- 检查范围/输出配置、读回异常、带符号换算、Z 轴 1 g、温度、首次姿态初始化、X 轴 90°、pitch 跨界、Kalman 静态稳定、tick 回绕、200 新样本零偏、无新数据不重复处理、读失败不提交样本及停止采样。
- 原厂资料依据和软件模拟不代替硬件验证。接线/上拉、器件真伪与 ID、实际采样率、零偏稳定性、六面误差、安装方向、运动时饱和及滤波表现仍待用户上板验收。

## 用户实测记录与阶段交接

用户更换 MPU6050 后确认通信恢复，日志显示 WHO/config 成功，约 100 Hz 有效采样，最大间隔约 14 ms。平放加速度合模约 1.15 g；本阶段未完成六面标定，不能据此宣称加速度精度或跌倒判据已通过，需在 C06 继续处理量程、标定和安装参考轴。

用户随后确认屏幕恢复正常并要求进入 C05。此次提交按当前工程保存配置，PB4/PB5 在 .ioc 与生成的 gpio.c 中仍为 GPIO_SPEED_FREQ_HIGH；未由 Agent 擅自修改为其他值。屏幕和 IMU 同时运行时的采样间隔继续通过日志观察。

## 回退 C04 后的串口配置调整

用户要求恢复 f7f1969 的 C04 状态后，再单独将 USART2 设置为 115200 8N1。此次只更新 .ioc 的 USART2.BaudRate，并应用 CubeMX 在隔离目录重新生成的 usart.c；生成文件与原文件的唯一代码差异为波特率。GPS 引脚保持 PA2/PA3，C04 其他功能不变。用户已将 ATGM336H 实际模块波特率设置为 115200，与 USART2 一致；模拟串口工具也应使用 115200。CubeMX 若已经打开旧工程，请重新载入更新后的 .ioc 再继续操作。
