tnzhy06/fallguard/docs/C06标定验收.md

# C06 标定功能已撤销

2026-10-25，用户要求删除所有 MPU6050 和姿态检测相关代码。原桌面标定功能与测试已移除，本文不再提供六面采集或 K2 标定操作。

当前已按用户最新要求重新接入 MPU6050 六轴与 Roll/Pitch 实时显示，见 [当前操作](MPU6050实时显示.md)。K2 仍只开启/取消本地测试报警；六面标定采集仍未恢复；用户后续已确认加入 [简单跌倒演示](简单跌倒演示验收.md)。

删除范围、构建和验证见 [移除记录](移除MPU6050说明.md)。历史候选研究可见 [算法选型记录](C06算法选型.md)，不代表当前实现。
