tnzhy06/fallguard/docs/C06算法选型.md

# C06 跌倒检测算法选型（历史记录）

> 当前状态：以下复杂方案为历史研究，用户后续已选择 [简单角度保持演示](简单跌倒演示验收.md)，旧三段式未启用。MPU6050 六轴及 Roll/Pitch 实时显示已按用户后续要求重新接入；下文仅保存此前算法调研，不作为当前开发或验收步骤。

调研日期：2026-10-25。先将已验收 C05 推送到 [192dd30](https://github.com/tnzhy06/fallguard/commit/192dd30bb0c6b0089e8cfefb9ca4f908d651d6c9)，再开展本阶段。

选择条件：适合腰带安装、100 Hz、STM32F103 裸机 C；无需动态内存、RTOS 或训练环境；可解释其时序，并有明确可复用的许可证。以下是本次实际查看的候选，不表示穷尽所有开源实现。

| 候选与固定提交 | 实际源码检查 | 决定 |
|---|---|---|
| [smart-fall-detection-bracelet](https://github.com/LeticiaVeran/smart-fall-detection-bracelet/tree/05f07c2bf9a3e20f55671fb2a8b683652fb236da) | 有 MIT LICENSE；[main.ino](https://github.com/LeticiaVeran/smart-fall-detection-bracelet/blob/05f07c2bf9a3e20f55671fb2a8b683652fb236da/firmware/main/main.ino) 面向手腕、约 20 Hz、±4 g/±500 dps；夹杂 Wi-Fi/MQTT 和阻塞延时。REST_DURATION 后仅检查一次 magRaw < REST_THRESHOLD，并非连续静止，没有本项目的直立姿态参考 | 不直接移植其完整算法，也不搬用其原始 LSB 阈值 |
| [fallsense-firmware](https://github.com/Fall-Guys/fallsense-firmware/tree/e53e4c08cd3ca9d84d5f2ead1b981a777db098e8) | [FallSense-MK1.ino](https://github.com/Fall-Guys/fallsense-firmware/blob/e53e4c08cd3ca9d84d5f2ead1b981a777db098e8/FallSense-MK1.ino) 为 Arduino/ESP32/BLE，检测依赖设备已连接，带阻塞延时；定时后检查一次角速度。该快照文件树中未找到 LICENSE | 不复制代码 |
| [esp32-fall-detector](https://github.com/MadlyFriese/esp32-fall-detector/tree/3fc00102ade5acc99c94f58b7a1a978b0530d97f) | 固件提取 200×6 样本的 32 维特征，使用训练的线性 SVM 与冲击门限；配置和模型对应其采样/量程/数据集。该快照文件树中未找到 LICENSE | 与本项目已规划的三段时序及现场标定流程不同，不复制模型或源码 |

结论：本次未找到可直接采用的完整实现，按本项目设计自行编写 C 模块。仍复用 C04 已移植的 leech001 MPU6050 双轴 Kalman 滤波结果；不重复引入传感器驱动或新的姿态库。没有把候选源码放入 ThirdParty，也不声称算法来自这些项目。

用户随后确认：**先做标定版，实测后定阈值；MPU6050 尚未固定，先在桌面验证。** 因此本轮只实现定长记录、统计和相对测试参考倾角，不启用自动跌倒报警。阶段③入口期限、保持时间、静止判据，以及样本间断处理仍待标定后明确确认。

后续 C06 顺序：桌面六面数据与静止噪声 → 记录安装方向及佩戴直立参考 → 正常动作/受控装置运动记录 → 确认三段条件和时间边界 → 实现状态机与 10 s 撤销交互 → 上板验收。不能把桌面参考当成身体直立，也不能用软件回放代替实际检出率验证。
