tnzhy06/fallguard/docs/MPU6050实时显示.md

# MPU6050 六轴与 Roll/Pitch 实时显示

## 本次范围

按用户最新要求重新移植 [leech001/MPU6050](https://github.com/leech001/MPU6050)，固定上游提交 [37856b26bedd32e04d4cead2d6c028125d4a3ba7](https://github.com/leech001/MPU6050/commit/37856b26bedd32e04d4cead2d6c028125d4a3ba7)。已核对当前 master 与该提交一致。版权、GPL-3.0-or-later、原始文件对应关系与修正见 [移植记录](../ThirdParty/leech001_mpu6050/README.md)。

仅恢复三轴加速度、三轴角速度和双轴 Kalman 角的读取、OLED 同屏显示与串口输出；六面采集及身体参考仍未接入；后续已按用户确认加入 [60°/1秒简单跌倒演示](简单跌倒演示验收.md)。

## 接线与配置

| 模块 | STM32 |
|---|---|
| SCL | PB6 / I2C1_SCL |
| SDA | PB7 / I2C1_SDA |
| GND | 共地 |
| VCC | 按模块要求供电，I2C 上拉至 3.3 V |
| AD0 | GND，对应 7 位地址 0x68 |
| INT / XDA / XCL | 本次不接 |

沿用已有 I2C1 400 kHz，不更改引脚或 .ioc。传感器配置为 ±2 g、±250°/s、DLPF_CFG=3、SMPLRT_DIV=9，目标 100 Hz；主循环轮询 DATA_RDY，每个新样本只处理一次，不使用 DMA 或 RTOS。

开机保持设备静止约 3 秒，启动会采集 200 个新样本计算陀螺零偏，完成后开始实时输出。此过程不能自动识别运动，若启动时移动过，应放稳后复位。加速度使用名义 16384 LSB/g，陀螺使用 131 LSB/(°/s)，不套用上游板子的 Z 轴 14418 修正，也不冒充已做六面标定。

## OLED

默认 MPU6050 页，约每 100 ms 刷新。八个数值同屏显示：

```text
MPU6050 LIVE
AX:+0.087  GX:-0.21
AY:-0.010  GY:+0.21
AZ:+1.144  GZ:-1.00
Roll : -0.58 deg
Pitch: -4.54 deg
A:g G:deg/s
FALL:READY DT:10
```

这是格式示例，不是本次硬件测量值。AX/AY/AZ 单位为 g，GX/GY/GZ 单位为 °/s（已减开机零偏），Roll/Pitch 单位为度；底部为当前演示状态与样本间隔；有效样本数 N 继续通过串口输出。

- INIT：等待初始化和首个样本。
- CAL...：正在采集开机陀螺零偏，保持静止。
- LIVE：当前数据有效。
- ERROR：通信、ID 或配置失败，显示 --，不继续把旧读数当实时数据；查看串口具体错误后复位。

Roll 对应上游 KalmanAngleX，使用 atan2(ay, sqrt(ax²+az²))；Pitch 对应 KalmanAngleY，使用 atan2(-ax, az) 并保留跨 ±180° 处理。它们是模块坐标系中的双轴姿态估计，不是安装标定后的身体倾角，也没有航向角。

K1 循环：**MPU6050（默认）→ GPS 信息 → GPS 信号 → 字符演示 → 中文演示 → 图形演示 → MPU6050**。K2 在任意页手动触发或取消报警；消警后扶正才能再次自动触发，不执行六面数据采集。

## 调试串口

USART1：PA9/PA10，115200 8N1。输出类别和周期统一在 [debug_config.h](../BSP/debug_config.h) 配置，默认只开 MPU 数据与错误；详见 [调试输出配置](调试串口输出配置.md)。每约 200 ms 开始输出一组数据，组内三行间隔至少 20 ms，全部来自同一次采样快照；同一个 n 表示同组：

```text
[MPU] n=1234 A mg=87,-10,1144
[MPU] n=1234 G mdps=-213,217,-1004
[MPU] n=1234 Roll=-58 Pitch=-454 cdeg dt=10 max=14
```

| 串口字段 | 换算 |
|---|---|
| A mg | 除以 1000 得到 g，例如 1144 = 1.144 g |
| G mdps | 除以 1000 得到 °/s，例如 -213 = -0.213°/s |
| Roll/Pitch cdeg | 除以 100 得到度，例如 -454 = -4.54° |
| dt / max | 当前/历史最大有效样本间隔，ms |

分成短行并错开发送，避免把八项数值挤成一条长阻塞日志；仍为固定缓冲/整数输出，不启用浮点 printf。GPS 轮询继续执行，GPS 诊断日志默认关闭，开启后在空闲时隙输出。100 Hz 是传感器配置目标，真实有效采样率和间隔须根据 n、时间及 dt/max 上板确认。

## 文件与验证

- [bsp_mpu6050.c/h](../BSP/bsp_mpu6050.c)：时间片启动、200 样本陀螺零偏与整数数据接口。
- [移植源文件](../ThirdParty/leech001_mpu6050/mpu6050.c)：14 字节整组读取、数据就绪、Kalman、返回值与配置读回检查。
- [app_main.c](../App/app_main.c)：传感器调度及同一快照的三行日志。
- [app_ui.c](../App/app_ui.c)：八项数据显示、初始化/故障占位符与六页循环。
- 根 CMakeLists.txt：源文件与 include；Core/Src/main.c 仅 USER CODE 更新提示。
- [回放测试](../tests/mpu6050/README.md)：实际驱动与串口输出逻辑的桌面测试。

Debug 编译通过，RAM 6104 B，FLASH 56388 B。驱动换算、数据就绪/错误、首帧姿态、±90° Roll、混合姿态、Pitch 跨界、tick 回绕及零偏测试通过；串口同组快照与错误后停止旧数据测试通过；实际 OLED 帧缓冲的八项值、正负边界、初始化/故障/翻页已检查。

烧录 [fallguard.elf](../build/Debug/fallguard.elf)，静置启动约 3 秒后确认 LIVE；缓慢改变姿态，核对 OLED 八项数值和同组串口输出随之更新，同时检查 GPS drop/uart 和传感器 dt/max。**真实硬件通信、姿态方向/精度和多任务运行间隔尚待本轮上板验收。**
