tnzhy06/fallguard/docs/开源项目地址.md

[zeruns/STM32G4-OLED-SSD1306-I2C-HAL: 基于STM32G474的0.96寸OLED(SSD1306)显示屏驱动程序（4针脚I2C接口），支持硬件IIC/软件IIC，HAL库版。](https://github.com/zeruns/STM32G4-OLED-SSD1306-I2C-HAL)

[MaJerle/lwgps: Lightweight GPS NMEA parser for embedded systems](https://github.com/MaJerle/lwgps)

[leech001/MPU6050: STM32 HAL library for GY-521 (MPU6050) with Kalman filter](https://github.com/leech001/MPU6050)

## C06 算法调研

候选来源、固定提交、源码检查与未直接采用的原因见 [C06算法选型](C06算法选型.md)。相关实现已按用户最新要求移除，记录仅供历史参考。
