tnzhy06/fallguard/docs/移除MPU6050说明.md

# 移除 MPU6050 和姿态检测实现（历史记录）

> 后续用户已要求重新移植 leech001/MPU6050 并实时显示六轴与 Roll/Pitch。下文仅记录此前移除过程，当前功能见 [实时显示验收](MPU6050实时显示.md)。C06 标定采集与自动跌倒检测仍未恢复。

按用户 2026-10-25 的要求，删除当前工程中的相关代码：

- BSP/bsp_mpu6050.c/h：传感器驱动封装与开机陀螺校准。
- ThirdParty/leech001_mpu6050/：第三方 MPU6050 驱动、Kalman 滤波及配套许可证/说明。
- App/app_fall.c/h：C06 标定、姿态计算、采样记录及统计。
- tests/c06_calibration/：该功能的专用测试。
- App 调度、标定页面、按键标定分支、串口日志、根 CMake 源文件和 include 引用。

当前仍运行 GPS NMEA 解析与信号显示、OLED 五页、K1 翻页、K2 本地测试报警和 LED。默认页为 GPS 信息，不再有标定页和开机保持静止提示。

Core 仅修改 main.c USER CODE 内的提示。保留原有引脚、.ioc 与通用 I2C1 初始化，不执行 MPU6050 寄存器读写。原始模块资料与历史设计文档作为资料保留；C04/C06 记录明确标为历史或撤销，不要求继续六面采集。

软件验证：Debug 编译通过（RAM 5648 B，FLASH 45628 B）；核对最终 ELF 和编译数据库不包含 MPU6050、Kalman、app_fall 实现。源码接入通过严格编译检查，OLED 翻页/报警回放通过；本次调整后的实际硬件运行待验证。
