tnzhy06/fallguard/docs/需求文档.md

【问题描述】

项目组成员自行完成对整个项目系统的设计，完成一套较为简便可靠的腰带装置，可

以获得生活不便者定位与状态。

【用户需求】

·系统应能解析json报文，后端与嵌入式之间用mqtt协议通信，json字符串交互。

·系统应能解析NMEA报文，获得生活不便者位置信息。

·系统应能通过加速度传感器判断其是否跌倒。

·系统应能通过网络上报经纬度信息，如果人员跌倒则上报人员跌倒的提示信息。

·系统应有一个报警装置，在人员跌倒时发声报警，要求中文语音。

·系统应有向服务器实时发送人员的位置信息和状态。

·系统还能够区分人员正常躺下和跌倒，减少误报。

·系统一块小型oled屏幕，实时刷新显示如下内容：时间日期，网络状态，GPS卫星信号强度，位置信息（如单页显示不下允许滑动多页显示，请合理设计显示界面）。

·其他创新性设计。

【器材选用】

·STM32F103RCT6开发板，atgm336GPS模块，MPU6050传感器,ESP01S模块,JQ8900模块，0.96寸oled，led灯
