tnzhy06/fallguard/Core/Inc/main.h

#define ESP_EN_Pin GPIO_PIN_0
#define ESP_EN_GPIO_Port GPIOB
#define KEY1_Pin GPIO_PIN_8
#define KEY1_GPIO_Port GPIOC
#define KEY2_Pin GPIO_PIN_9
#define KEY2_GPIO_Port GPIOC
#define LED_Pin GPIO_PIN_8
#define LED_GPIO_Port GPIOA
#define OLED_SCL_Pin GPIO_PIN_4
#define OLED_SCL_GPIO_Port GPIOB
#define OLED_SDA_Pin GPIO_PIN_5
#define OLED_SDA_GPIO_Port GPIOB
