tnzhy06/fallguard/Core/Src/main.c

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
/* Includes ------------------------------------------------------------------*/
#include "main.h"
#include "dma.h"
#include "i2c.h"
#include "i2s.h"
#include "rtc.h"
#include "tim.h"
#include "usart.h"
#include "gpio.h"

/* USER CODE BEGIN Includes */
#include "app_main.h"
#include "debug_config.h"
#include "bsp_gps.h"
#include "bsp_esp.h"
#include <errno.h>
#include <stdio.h>
/* USER CODE END Includes */


/* USER CODE BEGIN PV */
static uint8_t gps_rx_byte;
static volatile uint8_t gps_rx_retry;
static uint32_t gps_rx_retry_tick;
static uint8_t esp_rx_byte;
static volatile uint8_t esp_rx_retry;
static uint32_t esp_rx_retry_tick;

/* USER CODE END PV */

void SystemClock_Config(void);
/* USER CODE BEGIN 0 */
static void gps_receive_start(void)
{
    HAL_StatusTypeDef status = HAL_UART_Receive_IT(&huart2, &gps_rx_byte, 1U);

    gps_rx_retry = (status != HAL_OK) && (huart2.RxState != HAL_UART_STATE_BUSY_RX);
    if (gps_rx_retry != 0U)
        BSP_GPS_RxError(HAL_UART_GetError(&huart2) | 0x80000000UL);
}

static void esp_receive_start(void)
{
    HAL_StatusTypeDef status = HAL_UART_Receive_IT(&huart3, &esp_rx_byte, 1U);

    esp_rx_retry = (status != HAL_OK) && (huart3.RxState != HAL_UART_STATE_BUSY_RX);
    if (esp_rx_retry != 0U)
        BSP_ESP_RxError(HAL_UART_GetError(&huart3) | 0x80000000UL);
}
/* USER CODE END 0 */

/**
  * @brief  The application entry point.
  * @retval int
  */
int main(void)
{

  /* MCU Configuration--------------------------------------------------------*/

  /* Reset of all peripherals, Initializes the Flash interface and the Systick. */
  HAL_Init();

  /* Configure the system clock */
  SystemClock_Config();

  /* Initialize all configured peripherals */
  MX_GPIO_Init();
  MX_DMA_Init();
  MX_I2C1_Init();
  MX_RTC_Init();
  MX_TIM2_Init();
  MX_USART1_UART_Init();
  MX_USART2_UART_Init();
  MX_USART3_UART_Init();
  MX_I2S2_Init();
  /* USER CODE BEGIN 2 */
  setvbuf(stdout, NULL, _IONBF, 0);

  DEBUG_PRINT(DEBUG_LOG_BOOT, "\r\n[BOOT] fallguard\r\n");
  DEBUG_PRINT(DEBUG_LOG_BOOT, "[BOOT] HCLK=%lu Hz LSE_READY=%lu\r\n",
         (unsigned long)HAL_RCC_GetHCLKFreq(),
         (unsigned long)(__HAL_RCC_GET_FLAG(RCC_FLAG_LSERDY) != RESET));

  if (HAL_TIM_Base_Start(&htim2) != HAL_OK)
  {
    DEBUG_PRINT(DEBUG_LOG_ERRORS, "[TIM] TIM2 start failed\r\n");
    Error_Handler();
  }

  DEBUG_PRINT(DEBUG_LOG_BOOT, "[MPU] PB6=SCL PB7=SDA @0x68; keep STILL (~3s), 100Hz 2g/250dps\r\n");
  app_init();
  gps_receive_start();
  gps_rx_retry_tick = HAL_GetTick();
  esp_receive_start();
  esp_rx_retry_tick = HAL_GetTick();
  DEBUG_PRINT(DEBUG_LOG_BOOT, "[GPS] TX->PA3, USART2 115200 8N1, stale=5000ms\r\n");

  DEBUG_PRINT(DEBUG_LOG_BOOT, "[TIM] TIM2 started; MQTT/RTC pages show network and time\r\n");
  DEBUG_PRINT(DEBUG_LOG_BOOT, "[OLED] PB4=SCL PB5=SDA @0x3C; init pending\r\n");
  DEBUG_PRINT(DEBUG_LOG_BOOT, "[KEY] K1=OLED page; K2=test alarm; debounce=20ms\r\n");
  /* USER CODE END 2 */

  /* Infinite loop */
  /* USER CODE BEGIN WHILE */
  while (1)
  {
    /* USER CODE END WHILE */

    /* USER CODE BEGIN 3 */
    if ((gps_rx_retry != 0U) &&
        ((uint32_t)(HAL_GetTick() - gps_rx_retry_tick) >= 5U))
    {
      gps_rx_retry_tick = HAL_GetTick();
      gps_receive_start();
    }
    if ((esp_rx_retry != 0U) &&
        ((uint32_t)(HAL_GetTick() - esp_rx_retry_tick) >= 5U))
    {
      esp_rx_retry_tick = HAL_GetTick();
      esp_receive_start();
    }
    app_run();
  }
  /* USER CODE END 3 */
}

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
/* USER CODE BEGIN 4 */
void HAL_UART_RxCpltCallback(UART_HandleTypeDef *huart)
{
    if (huart == &huart2)
    {
        /* Rearming clears ErrorCode before HAL can finish handling an overrun. */
        if (HAL_UART_GetError(huart) == HAL_UART_ERROR_NONE)
        {
            BSP_GPS_RxByte(gps_rx_byte);
            gps_receive_start();
        }
    }
    else if (huart == &huart3)
    {
        if (HAL_UART_GetError(huart) == HAL_UART_ERROR_NONE)
        {
            BSP_ESP_RxByte(esp_rx_byte);
            esp_receive_start();
        }
    }
}

void HAL_UART_ErrorCallback(UART_HandleTypeDef *huart)
{
    if (huart == &huart2)
    {
        BSP_GPS_RxError(HAL_UART_GetError(huart));
        if (huart->RxState == HAL_UART_STATE_READY)
            gps_receive_start();
    }
    else if (huart == &huart3)
    {
        BSP_ESP_RxError(HAL_UART_GetError(huart));
        if (huart->RxState == HAL_UART_STATE_READY)
            esp_receive_start();
    }
}

int _write(int file, char *ptr, int len)
{
    (void)file;

    if (len == 0)
    {
        return 0;
    }
    if ((len < 0) || (len > UINT16_MAX))
    {
        errno = EINVAL;
        return -1;
    }

    /* Bound logging time so a UART fault cannot stall the polling loop. */
    if (HAL_UART_Transmit(&huart1, (uint8_t *)ptr, (uint16_t)len, 20U) != HAL_OK)
    {
        errno = EIO;
        return -1;
    }
    return len;
}
/* USER CODE END 4 */
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
