tnzhy06/fallguard/docs/ATGM336H-5N模块资料/例程参考/6.51单片机STC89C52例程/其它供参考例程/GPS信息获取代码（LCD12864带字库液晶并行模式）V1.7/main.c

#include "main.h"
#include "LCD12864.h"
#include "GPS.h"

//定义变量
unsigned char KEY_NUM = 0;
bit Page = 0;
unsigned char xdata Display_GPGGA_Buffer[68];
unsigned char xdata Display_GPRMC_Buffer[68];
bit Flag_OV = 0;
bit Flag_Calc_GPGGA_OK = 0;
bit Flag_Calc_GPRMC_OK = 0;

//****************************************************
//主函数
//****************************************************
void main()
{
	unsigned char i = 0;
	LCD12864_Reset();								//初始化液晶
	LCD12864_HAIZI_SET();							//设置为普通模式
	
	Delay_ms(100);
	

	LCD12864_COM_Write(0x80);						//指针设置
	LCD12864_write_word("※※※※※※※※");
	LCD12864_COM_Write(0x90);						//指针设置
	LCD12864_write_word("    欢迎使用    ");			
	LCD12864_COM_Write(0x88);						//指针设置
	LCD12864_write_word("正在初始化GPS...");
	LCD12864_COM_Write(0x98);						//指针设置
	LCD12864_write_word("※※※※※※※※");

	Uart_Init();

	while(1)
	{
		Scan_Key();
		if(Flag_GPS_OK == 1 && RX_Buffer[4] == 'G' && RX_Buffer[6] == ',' && RX_Buffer[13] == '.')			//确定是否收到"GPGGA"这一帧数据
		{
			for( i = 0; i < 68 ; i++)
			{
				Display_GPGGA_Buffer[i] = RX_Buffer[i];	
			}
			Hour = (Display_GPGGA_Buffer[7]-0x30)*10+(Display_GPGGA_Buffer[8]-0x30)+8;			//UTC时间转换到北京时间UTC+8    
																								//0X30为ASCII码转换为数字
				if( Hour >= 24)				//溢出
			{
				Hour %= 24;				//获取当前Hour
				Flag_OV = 1;			//日期进位
			}
			else
			{
				Flag_OV = 0;
			}

			Min_High = Display_GPGGA_Buffer[9];
			Min_Low = Display_GPGGA_Buffer[10];
	
			Sec_High = Display_GPGGA_Buffer[11];
			Sec_Low = Display_GPGGA_Buffer[12];

			Flag_Calc_GPGGA_OK = 1;
		}

		if(Page == 0 && Flag_Calc_GPGGA_OK == 1)
		{
//			LED1 = ~LED1;
			Flag_Calc_GPGGA_OK = 0;
		
			LCD12864_COM_Write(0x80);			//设置指针
			LCD12864_write_word("★");				//显示内容
			LCD12864_Data_Write(Hour/10+0x30);
			LCD12864_Data_Write(Hour%10+0x30);
			LCD12864_write_word("时");
	
			LCD12864_Data_Write(Min_High);
			LCD12864_Data_Write(Min_Low);
			LCD12864_write_word("分");
	
			LCD12864_Data_Write(Sec_High);
			LCD12864_Data_Write(Sec_Low);
			LCD12864_write_word("秒");
			LCD12864_write_word("★");
	
	
			LCD12864_COM_Write(0x90);			//设置指针
			
			LCD12864_Data_Write(Display_GPGGA_Buffer[28]);			//N 或者 S
			LCD12864_Data_Write(' ');

			LCD12864_Data_Write(Display_GPGGA_Buffer[17]);			//纬度
			LCD12864_Data_Write(Display_GPGGA_Buffer[18]);			//纬度
			LCD12864_Data_Write(Display_GPGGA_Buffer[19]);			//纬度
			LCD12864_Data_Write(Display_GPGGA_Buffer[20]);			//纬度
			LCD12864_Data_Write(Display_GPGGA_Buffer[21]);			//纬度
			LCD12864_Data_Write(Display_GPGGA_Buffer[22]);			//纬度
			LCD12864_Data_Write(Display_GPGGA_Buffer[23]);			//纬度
			LCD12864_Data_Write(Display_GPGGA_Buffer[24]);			//纬度
			LCD12864_Data_Write(Display_GPGGA_Buffer[25]);			//纬度
			LCD12864_Data_Write(Display_GPGGA_Buffer[26]);			//纬度
			LCD12864_write_word("    ");


			LCD12864_COM_Write(0x88);			//设置指针
			
			LCD12864_Data_Write(Display_GPGGA_Buffer[42]);			//E 或者 W
			LCD12864_Data_Write(' ');

			LCD12864_Data_Write(Display_GPGGA_Buffer[30]);			//经度
			LCD12864_Data_Write(Display_GPGGA_Buffer[31]);	
			LCD12864_Data_Write(Display_GPGGA_Buffer[32]);	
			LCD12864_Data_Write(Display_GPGGA_Buffer[33]);			//经度
			LCD12864_Data_Write(Display_GPGGA_Buffer[34]);	
			LCD12864_Data_Write(Display_GPGGA_Buffer[35]);
			LCD12864_Data_Write(Display_GPGGA_Buffer[36]);	
			LCD12864_Data_Write(Display_GPGGA_Buffer[37]);
			LCD12864_Data_Write(Display_GPGGA_Buffer[38]);	
			LCD12864_Data_Write(Display_GPGGA_Buffer[39]);
			LCD12864_Data_Write(Display_GPGGA_Buffer[40]);
			LCD12864_write_word("   ");	

			LCD12864_COM_Write(0x98);			//设置指针
			LCD12864_write_word("海拔：    ");				//显示内容
			
			LCD12864_Data_Write(Display_GPGGA_Buffer[54]);	
			LCD12864_Data_Write(Display_GPGGA_Buffer[55]);	
			LCD12864_Data_Write(Display_GPGGA_Buffer[56]);	
			LCD12864_Data_Write(Display_GPGGA_Buffer[57]);
			LCD12864_write_word("米");			
		}
		
		if(Flag_GPS_OK == 1 && RX_Buffer[4] == 'M' && RX_Buffer[52] == ',' && RX_Buffer[59] == ',')			//确定是否收到"GPRMC"这一帧数据
		{
			for( i = 0; i < 68 ; i++)
			{
				Display_GPRMC_Buffer[i] = RX_Buffer[i];	
			}

			Year_High = Display_GPRMC_Buffer[57];
			Year_Low = Display_GPRMC_Buffer[58];

			Month_High = Display_GPRMC_Buffer[55];
			Month_Low = Display_GPRMC_Buffer[56];

			Day_High = Display_GPRMC_Buffer[53];
			Day_Low = Display_GPRMC_Buffer[54];


			if(Flag_OV == 1)			//有进位
			{
				UTCDate2LocalDate();			//UTC日期转换为北京时间		
			}

			Flag_Calc_GPRMC_OK = 1;
		}

		if(Page == 1 && Flag_Calc_GPRMC_OK == 1)
		{
//			LED1 = ~LED1;
			Flag_Calc_GPRMC_OK = 0;
			
			LCD12864_COM_Write(0x80);			//设置指针
			LCD12864_write_word("20");
			LCD12864_Data_Write(Year_High);
			LCD12864_Data_Write(Year_Low);
			LCD12864_write_word("年");
	
			LCD12864_Data_Write(Month_High);
			LCD12864_Data_Write(Month_Low);
			LCD12864_write_word("月");
	
			LCD12864_Data_Write(Day_High);
			LCD12864_Data_Write(Day_Low);
			LCD12864_write_word("日");
			
			
			LCD12864_COM_Write(0x90);			//设置指针
			LCD12864_write_word("速度：  ");				//显示内容

			LCD12864_Data_Write(' ');
			LCD12864_Data_Write(Display_GPRMC_Buffer[46]);		
			LCD12864_Data_Write(Display_GPRMC_Buffer[47]);		
			LCD12864_Data_Write(Display_GPRMC_Buffer[48]);			
			LCD12864_Data_Write(Display_GPRMC_Buffer[49]);	
			LCD12864_Data_Write(Display_GPRMC_Buffer[50]);
			
			LCD12864_write_word("米");
						
		}		
	}
}

//****************************************************
//UTC日期与当地日期转换
//****************************************************
void UTCDate2LocalDate(void)
{
	Day = (Day_High - 0x30) * 10 + (Day_Low-0x30) + 1;		//日  加一
	Month = (Month_High - 0x30) * 10 + (Month_Low - 0x30);
	Year = 2000 + (Year_High - 0x30) * 10 + (Year_Low - 0x30);
	
	MaxDay = GetMaxDay(Month,Year);				//获取当月 天数 最大值
	if(Day > MaxDay)		//溢出
	{
		Day = 1;
		Month += 1;
		if(Month > 12)
		{
			Year+=1;
		}
	}

	Day_High = Day/10 + 0x30;				//转换日期值为ASCII
	Day_Low = Day%10 + 0x30;

	Month_High = Month/10 + 0x30;			//转换月份值为ASCII
	Month_Low = Month%10 + 0x30;

	Year_High = Year%100/10 + 0x30;			//转换年份值为ASCII
	Year_Low = Year%10 + 0x30;			
}

//****************************************************
//获取当月日期最大值
//****************************************************
unsigned char GetMaxDay(unsigned char Month_Value,unsigned int Year_Value)
{
	unsigned char iDays;
	switch(Month_Value)
	{
		case 1:
		case 3:
		case 5:
		case 7:
		case 8:
		case 10:
		case 12:
			{
				iDays = 31;
			}
			break;
		case 2:
			{
				//2月份比较特殊，需要根据是不是闰年来判断当月是28天还29天
				iDays = IsLeapYear(Year_Value)?29:28;
			}
			break;
		case 4:
		case 6:
		case 9:
		case 11:
			{
				iDays = 30;
			}
			break;
		default : break;
	}
	return(iDays);						
}

//****************************************************
//闰年检测
//****************************************************
bit IsLeapYear(unsigned int uiYear)
{
	return (((uiYear%4)==0)&&((uiYear%100)!=0))||((uiYear%400)==0);
}


//****************************************************
//按键扫描程序
//****************************************************
void Scan_Key()
{
	if( KEY4 == 0 )	 					//按键1扫描
	{
		Delay_ms(10);					//延时去抖
		if( KEY4 == 0 )
		{
			while(KEY4 == 0);			//等待松手
			KEY_NUM = 4;
			Page = ~Page;
			LCD12864_COM_Write(0X01);	//清屏
		}
	}
}
//****************************************************
//MS延时函数(12M晶振下测试)
//****************************************************
void Delay_ms(unsigned int n)
{
	unsigned int  i,j;
	for(i=0;i<n;i++)
		for(j=0;j<123;j++);
}
