tnzhy06/fallguard/docs/ATGM336H-5N模块资料/例程参考/6.51单片机STC89C52例程/其它供参考例程/GPS信息获取代码（LCD12864带字库液晶并行模式）V1.7/main.h

#ifndef __MAIN_H__
#define __MAIN_H__

#include <reg52.h>

////LED IO设置
//sbit LED1 = P2^0;
//sbit LED2 = P2^1;
//#define LED_ON 0
//#define LED_OFF 1

//按键 IO设置
sbit KEY4 = P3^6;


//函数或者变量声明
extern void Delay_ms(unsigned int n);
extern void Scan_Key();
extern void UTCDate2LocalDate(void);
extern bit IsLeapYear(unsigned int uiYear);	
extern unsigned char GetMaxDay(unsigned char Month_Value,unsigned int Year_Value);




#endif
