tnzhy06/fallguard/tests/time_sync/config.h

#ifndef TEST_CONFIG_H
#define TEST_CONFIG_H
#define MQTT_CONFIG_LOCAL_H
#ifdef TEST_MQTT
#define MQTT_HOST "broker.test"
#else
#define MQTT_HOST ""
#endif
#define MQTT_PORT 1883U
#define MQTT_USERNAME "synthetic-user"
#define MQTT_PASSWORD "synthetic-password"
#define ESP_CONFIG_LOCAL_H
#ifdef TEST_NO_WIFI
#define ESP_WIFI_SSID ""
#else
#define ESP_WIFI_SSID "demo,\"ssid\\"
#endif
#define ESP_WIFI_PASSWORD "synthetic-test-password"
#include "../../BSP/debug_config.h"
#undef DEBUG_OUTPUT_ENABLE
#define DEBUG_OUTPUT_ENABLE 0
#endif
