tnzhy06/fallguard/App/app_ui_font.h

#ifndef APP_UI_FONT_H
#define APP_UI_FONT_H

#include <stdint.h>

/* A small subset avoids linking a full Chinese font into the firmware. */
typedef struct { char code[4]; uint8_t bitmap[32]; } app_ui_glyph_t;
static const app_ui_glyph_t ui_glyphs[] = {
    { "正", { 0x00, 0x02, 0x02, 0xC2, 0x02, 0x02, 0x02, 0xFE, 0x82, 0x82, 0x82, 0x82, 0x82, 0x02, 0x00, 0x00, 0x40, 0x40, 0x40, 0x7F, 0x40, 0x40, 0x40, 0x7F, 0x40, 0x40, 0x40, 0x40, 0x40, 0x40, 0x40, 0x00 } },
    { "常", { 0x20, 0x18, 0x08, 0xEA, 0xAC, 0xA8, 0xA8, 0xAF, 0xA8, 0xA8, 0xAC, 0xEA, 0x08, 0x28, 0x18, 0x00, 0x00, 0x00, 0x3E, 0x02, 0x02, 0x02, 0x02, 0xFF, 0x02, 0x02, 0x12, 0x22, 0x1E, 0x00, 0x00, 0x00 } },
    { "校", { 0x10, 0x10, 0xD0, 0xFF, 0x90, 0x10, 0x80, 0x48, 0x28, 0x09, 0x0E, 0x08, 0x28, 0x48, 0x88, 0x00, 0x04, 0x03, 0x00, 0xFF, 0x00, 0x01, 0x80, 0x80, 0x43, 0x2C, 0x10, 0x2C, 0x43, 0x80, 0x80, 0x00 } },
    { "准", { 0x00, 0x02, 0x0C, 0xE0, 0x40, 0x20, 0xF8, 0x4F, 0x48, 0x49, 0xFE, 0x48, 0x48, 0x48, 0x08, 0x00, 0x04, 0x04, 0x7F, 0x00, 0x00, 0x00, 0xFF, 0x22, 0x22, 0x22, 0x3F, 0x22, 0x22, 0x22, 0x20, 0x00 } },
    { "故", { 0x10, 0x10, 0x10, 0xFF, 0x10, 0x10, 0x50, 0x20, 0xD8, 0x17, 0x10, 0x10, 0xF0, 0x10, 0x10, 0x00, 0x00, 0x7F, 0x21, 0x21, 0x21, 0x7F, 0x80, 0x40, 0x21, 0x16, 0x08, 0x16, 0x21, 0x40, 0x80, 0x00 } },
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
    { "消", { 0x10, 0x60, 0x02, 0x0C, 0xC0, 0x00, 0xE2, 0x2C, 0x20, 0x3F, 0x20, 0x28, 0xE6, 0x00, 0x00, 0x00, 0x04, 0x04, 0x7C, 0x03, 0x00, 0x00, 0xFF, 0x09, 0x09, 0x09, 0x49, 0x89, 0x7F, 0x00, 0x00, 0x00 } },
};

#endif
