tnzhy06/fallguard/(commit log)

2026-10-23 Initialize fallguard STM32CubeMX HAL project
2026-10-24 Update STM32CubeMX peripheral configuration and project settings
2026-10-24 Add current fallguard configuration and project documentation
2026-10-24 feat: complete C01-C03 board bring-up and OLED port
2026-10-25 feat: add validated C07 JQ8900 one-wire alarm playback
2026-10-29 feat: configure 8 kHz I2S2 DMA and relocate ESP enable
2026-10-30 docs: streamline README and add hardware manuals
    Add repository-relative manual links and include docs. Keep debug output disabled in the current configuration.
